Vasil-Pahomov/PIC-Sunrise/sunrise.PDF

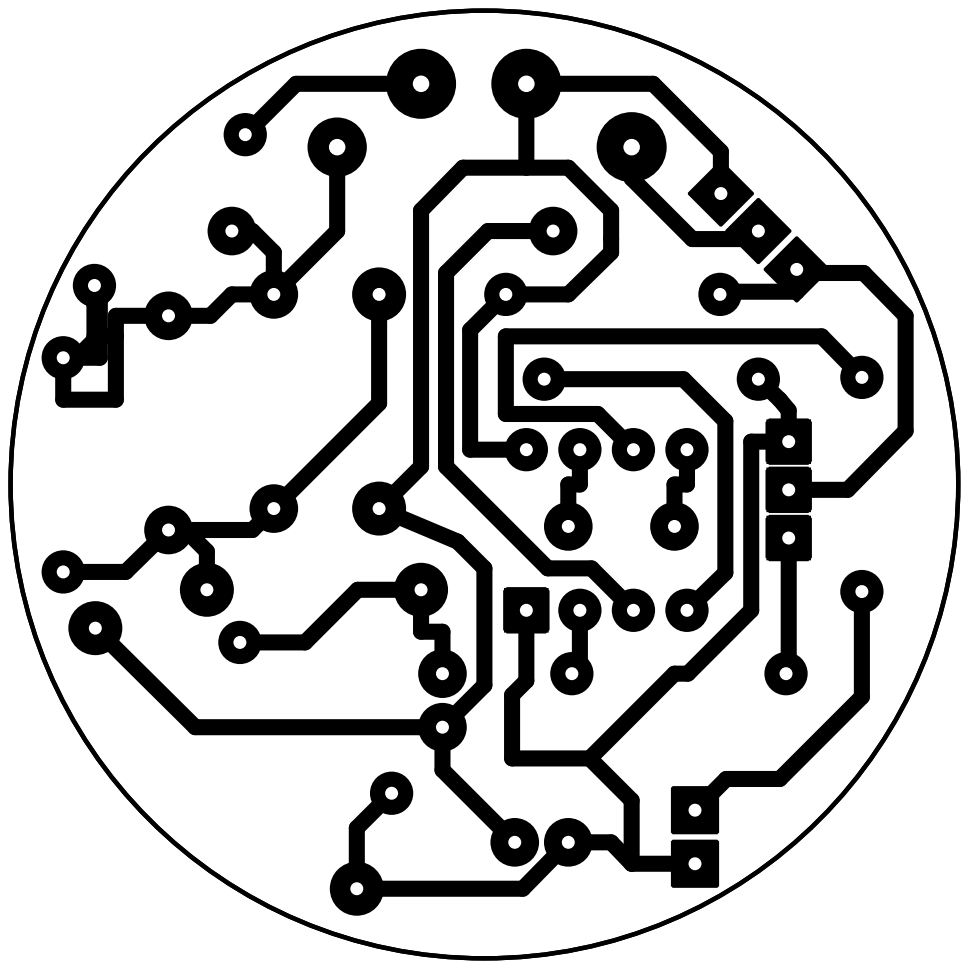
[picture p3: page 1]
