Vasil-Pahomov/PIC-Sunrise/(list of files, drawings)

Other design files:
sunrise.pdsprj
