Vasil-Pahomov/PIC-Sunrise/(commit log)

2017-11-27 Final working version with some previous versions
    [testt.pdsprj]
2019-02-09 Misc changes: - circuit made more beautiful - added some PCB missing routes - Proteus file renamed - added images and PCB PDF
    [sunrise.pdsprj, testt.pdsprj]
2019-02-10 Removing old source file versions, change encoding, add comment to MATLAB file, fixes in PCB
    [sunrise.pdsprj]
